sibernetika/Water-Level-Anak-Tangga/README.md

## Water Level Sensor - Prototype 
---

Folder structure : 
| Doc
    | - Water Level Monitoring Device.pdf       #documentation in pdf format
    | - Water Level Monitoring Device.pptx      #documentation in pptx format
| Src
    | dev                   #development code
    | water_level           #implemented code

Online platform dashboard : Cayenne.com
